amacleod/lampyrida/README.md

Lampyrida Macro Pad
===================

Just a small project for me to practice SK6812 RGB LED soldering.

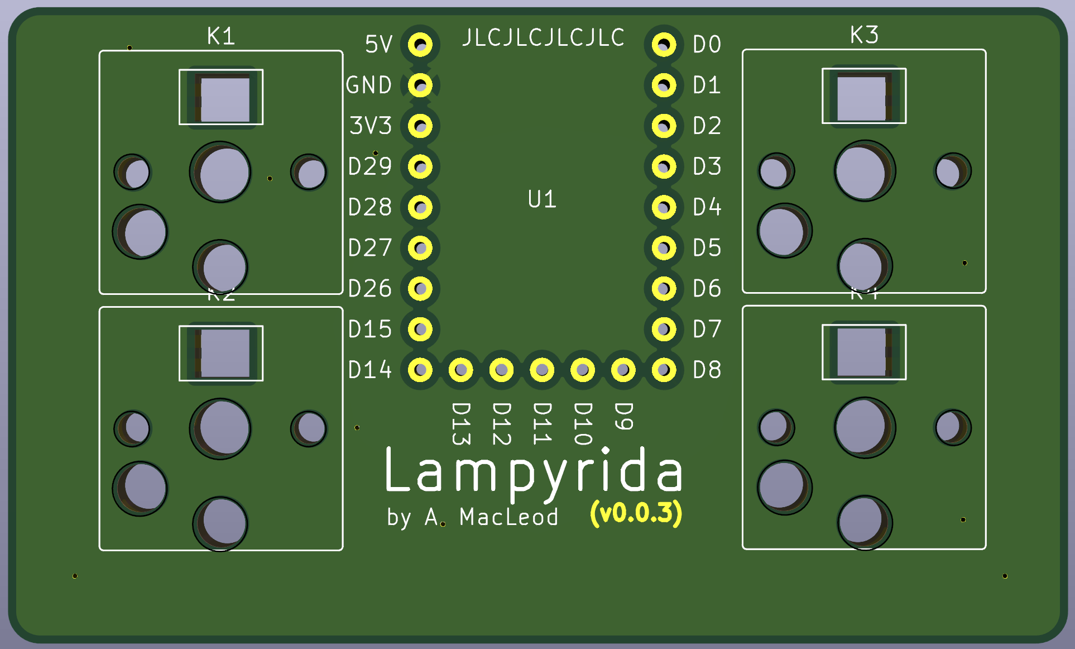
[picture p1: docs/Lampyrida.png]
lampyrida front Lampyrida Front Side
