amacleod/lampyrida/lampyrida.kicad_pcb

## KiCad design lampyrida.kicad_pcb (2025-05-19)

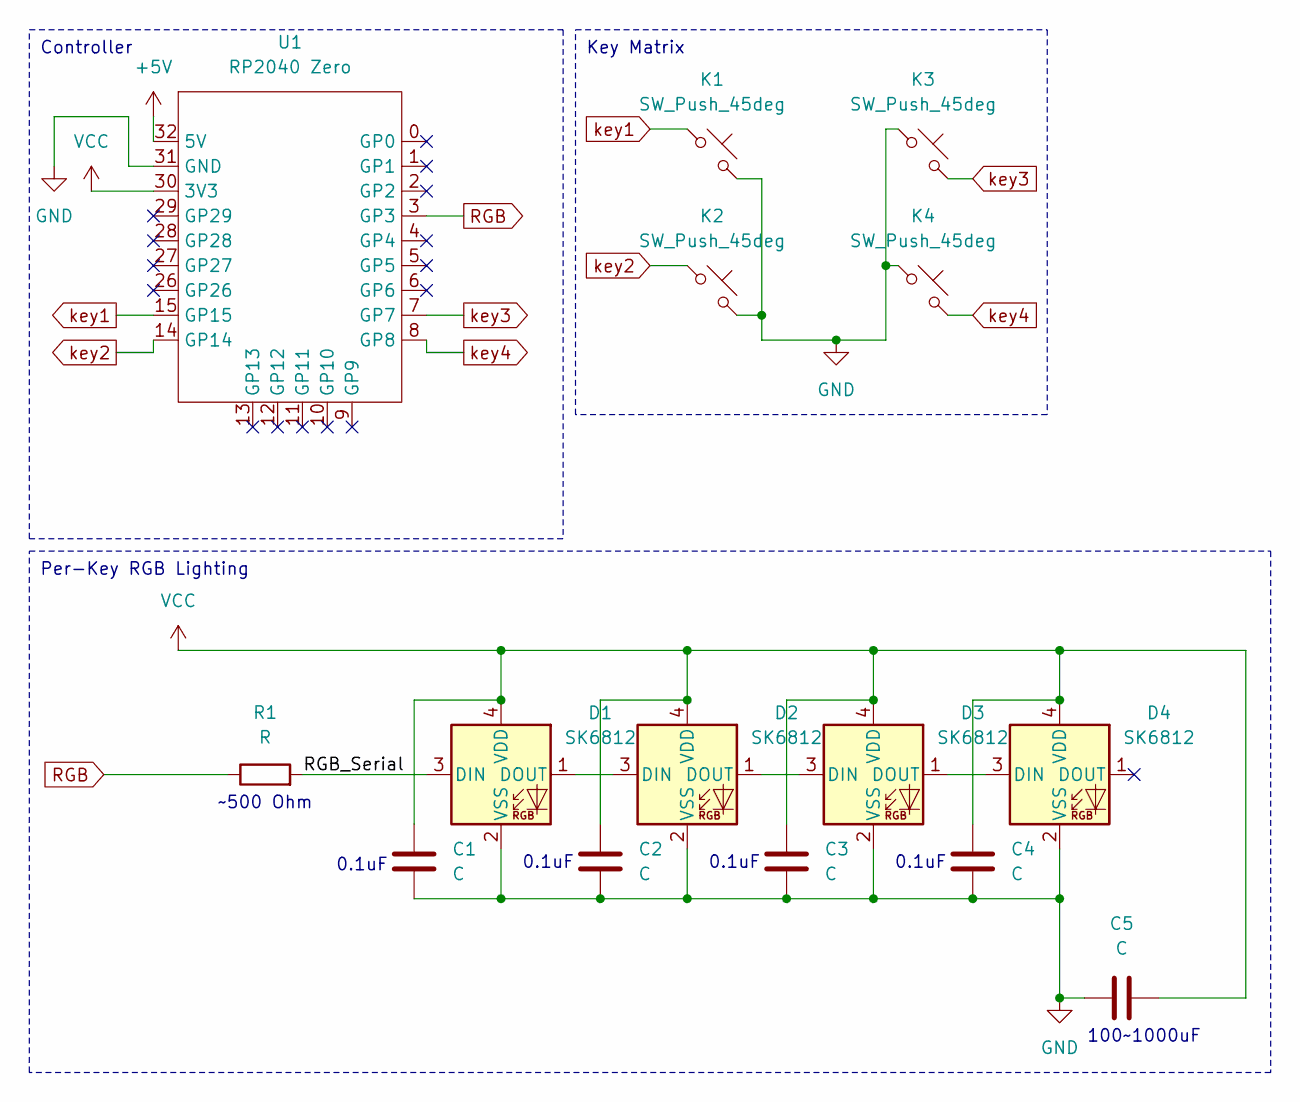
[picture p2: schematic lampyrida.kicad_sch]

Parts:
C1, C2, C3, C4, C5: C; C_1206_3216Metric_Pad1.33x1.80mm_HandSolder
D1, D2, D3, D4: SK6812; LED_RGB_SK6812Mini-E
K1, K2, K3, K4: SW_Push_45deg; Socket_PG1350_Hotswap
R1: R; R_1206_3216Metric_Pad1.30x1.75mm_HandSolder
U1: RP2040 Zero; RP2040 Zero (Through Hole)

Connections:
+5V: U1.32 (5V)
/RGB_Serial: D1.3 (DIN), R1.2
GND: C1.1, C2.1, C3.1, C4.1, C5.2, D1.2 (VSS), D2.2 (VSS), D3.2 (VSS), D4.2 (VSS), K1.2, K2.2, K3.1, K4.1, U1.31 (GND)
unnamed: D1.1 (DOUT), D2.3 (DIN)
unnamed: D2.1 (DOUT), D3.3 (DIN)
unnamed: D3.1 (DOUT), D4.3 (DIN)
RGB: R1.1, U1.3 (GP3)
VCC: C1.2, C2.2, C3.2, C4.2, C5.1, D1.4 (VDD), D2.4 (VDD), D3.4 (VDD), D4.4 (VDD), U1.30 (3V3)
key1: K1.1, U1.15 (GP15)
key2: K2.1, U1.14 (GP14)
key3: K3.2, U1.7 (GP7)
key4: K4.2, U1.8 (GP8)

Notes on the sheet:
Key Matrix
Per-Key RGB Lighting
Controller
0.1uF
100~1000uF
~500 Ohm

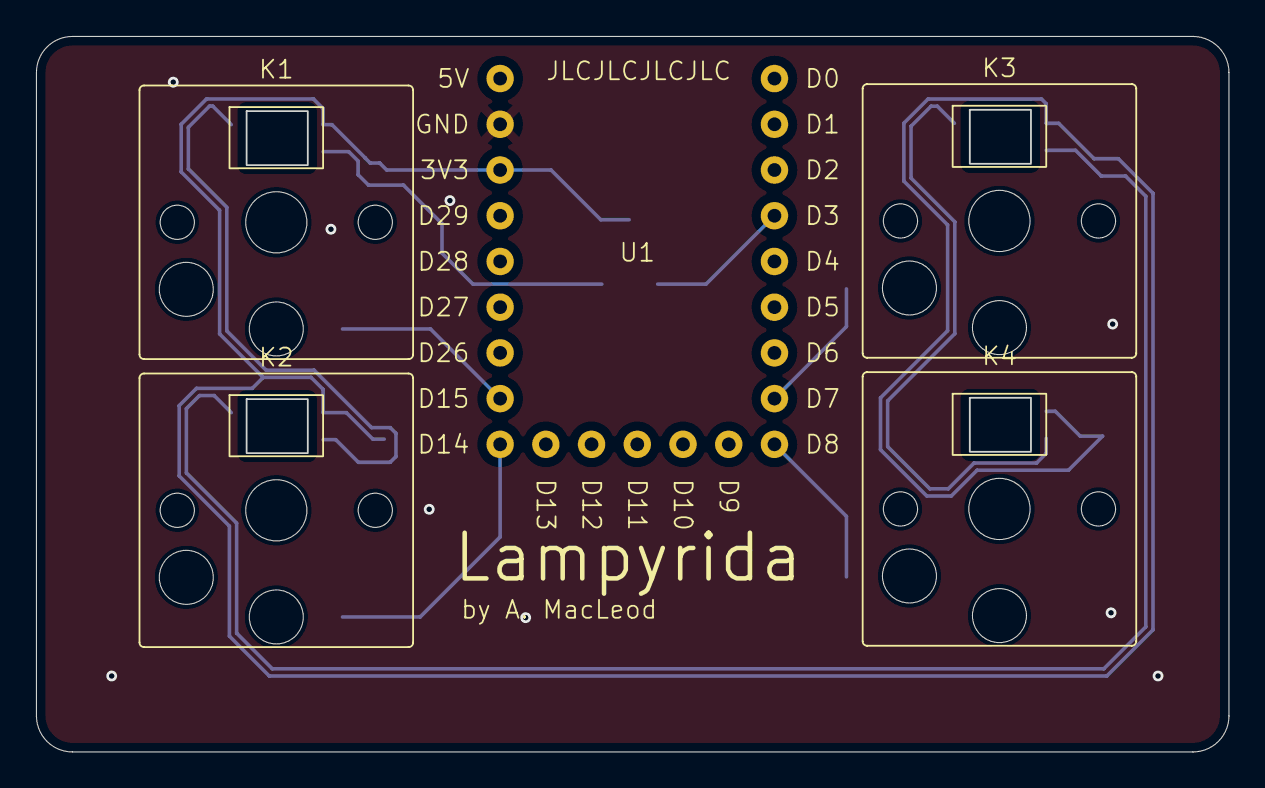
[picture p3: board lampyrida.kicad_pcb from above]

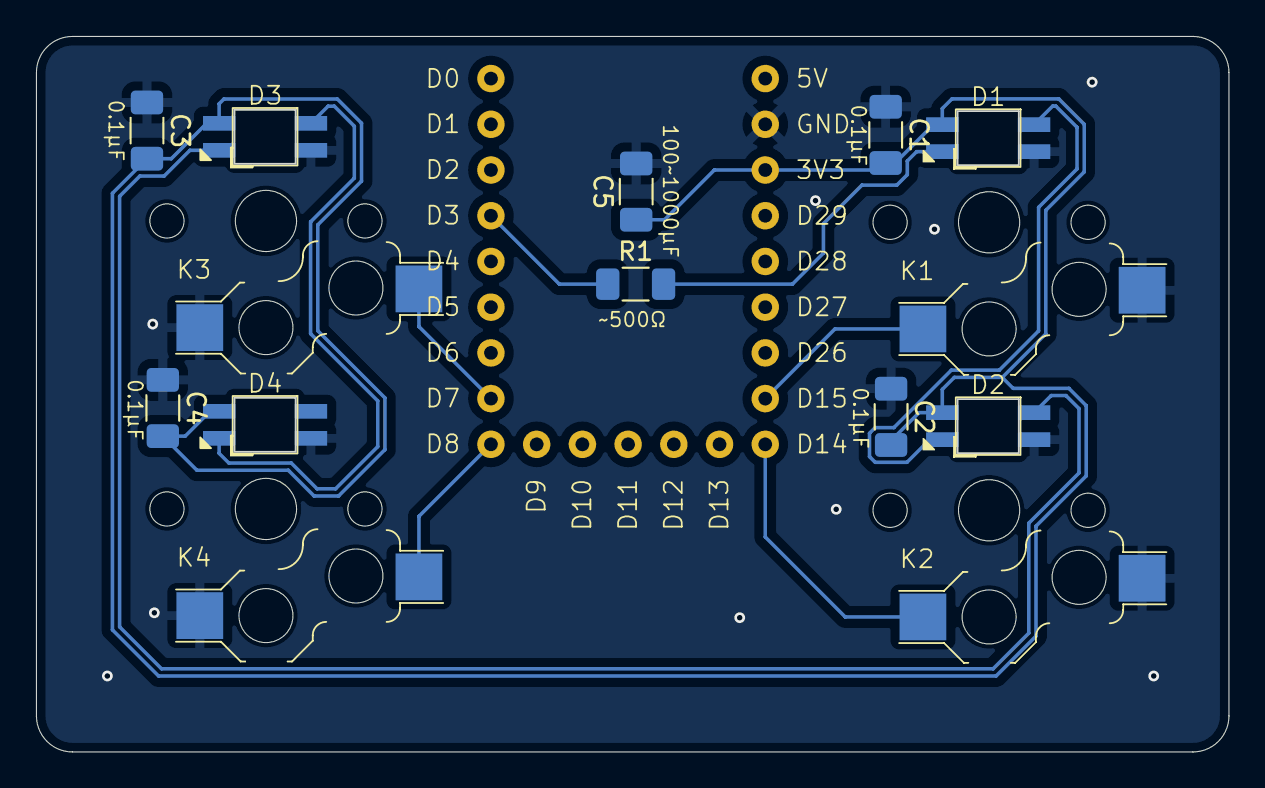
[picture p4: board lampyrida.kicad_pcb from below]

Board: 2 copper layers, 66.2 x 39.8 mm, 15 parts (6 on the bottom side), 11 nets.
