amacleod/lampyrida/(threads)

Thread 1 (2025-03-17):

SK6812 footprint needs adjustment

amacleod, 2025-03-17:
First off, I put them in upside down: the LEDs shine away from the back of the board (towards the bottom of the "keyboard") as opposed to shining upward through the cutouts in the board.

Secondly, the cutouts are not big enough for the shiny half of the LED housing. They are just barely big enough for the opaque half.

Thirdly, the solder pad lands are too far apart for the units I got from Adafruit: they are about the right size and horizontal distance, but they are too far apart vertically by about 0.5 to 1mm. Technically the legs of the unit do touch the pads, but they do not really overlap a lot.

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

Update the footprint so that:
- it is clear which way the LED will shine
- the cutout is big enough for the body of the front of the unit
- solder pad lands are big enough to have significant overlap with the legs

amacleod, 2025-05-18:
Bleh. It turns out I was using one of KiCad's built in footprints, which is apparently for a different size of NeoPixel. I was using `LED_SMD:LED_SK6812_PLCC4_5.0x5.0mm_P3.2mm`which is incorrect.

amacleod, 2025-05-18:
Closed by PR #8

Closed 2025-05-18.

Thread 2 (2025-03-17):

Move capacitors further from LED spots

amacleod, 2025-03-17:
We have plenty of room on the back of the board. Move the surface-mount capacitors to make more room for easy soldering.

Closed 2025-03-23.

Thread 3 (2025-03-17):

Silk screen label placement

amacleod, 2025-03-17:
Minor detail: some of the labels get covered up by components. Notably, half of the LED labels are covered up by hot swap sockets and two of the MCU pin labels are right under C5. It should be easy to move the labels or components around a little so that all the labels are visible even after populating all the components.

amacleod, 2025-05-18:
Mostly fixed by PR #8

Closed 2025-05-18.

Thread 4 (2025-03-17):

Shorten traces on K3 and K4

amacleod, 2025-03-17:
The traces to the keyswitches on the right side of the pad can be shortened and simplified if the ground pin of those switches is on the outer side of them, sort of mirroring the pin choice on K1 and K2.

Closed 2025-03-23.

Thread 5 (2025-03-21):

DIN should have an approximately 500 Ohm resistor

amacleod, 2025-03-21:
Per https://learn.adafruit.com/adafruit-neopixel-uberguide/basic-connections there should be a 470 Ohm resistor between the data output (the level shifter, in Lampyrida's case) and the data-in pin of the first NeoPixel. The datasheet at https://cdn-shop.adafruit.com/product-files/4960/4960_SK6812MINI-E_REV02_EN.pdf says "about 500 Ohm", so 470 should presumably be fine.

The stated purpose of this resistor is to protect the NeoPixels from overcurrent.

Closed 2025-03-23.

Thread 6 (2025-03-21):

Label capacitor values on schematic and PCB.

amacleod, 2025-03-21:
According to https://learn.adafruit.com/adafruit-neopixel-uberguide/basic-connections there should be a 100 to 1000 microfarad capacitor across the power terminals (C5 on the Lampyrida schematic) and a 0.1 microfarad (aka 100 nanofarad) capacitor for each NeoPixel. To aid in recalling those values when populating components, the fab (and possibly even silkscreen) should indicate those values.

Closed 2025-03-23.

Thread 7 (2025-03-21):

Fix ground plane continuity

amacleod, 2025-03-21:
The pads of the RP2040 Zero footprint make a mighty effective barrier against the ground plane on both sides of the PCB. Currently there are vias joining the inner portions of the ground plane, but there is nothing connecting any of the outer portions to the GND pin (except for the small region in the vicinity of C5).

Redo the routing to make sure that everything on the GND net is actually connected.

amacleod, 2025-03-21:
It may be worth deleting the pads for the bottom row of pins; I am not even using a header there.

Closed 2025-03-23.
