amacleod/lampyrida/(commit log)

2025-02-08 Lampyrida macropad v0.0.1
    [lampyrida.kicad_pcb, lampyrida.kicad_sch]
2025-02-26 Added Kee Boar KB2040 to the symbol library.
    [lampyrida.kicad_pcb]
2025-03-23 Add R1, improve ground plane, add labels.
    Fixes #7 by making more room for the ground pour to go around things
    and with some better-placed vias.
    Fixes #6 by adding labels, both in schematic and PCB, for capacitors
    and the new resistor.
    Fixes #5 by adding a spot for a 500-ish Ohm resistor on the LED data
    input line.
    Fixes #2 by moving C1 further away from the LED footprint.
    [lampyrida.kicad_pcb, lampyrida.kicad_sch]
2025-03-23 Fixes #4 by swapping which end of K3 and K4 is connected to ground.
    [lampyrida.kicad_pcb, lampyrida.kicad_sch]
2025-05-13 Removing level shifter to use 3.3V power and signal with SK2812 LEDs.
    [lampyrida.kicad_sch]
2025-05-13 Rerouting traces with new non-5V net.
    [lampyrida.kicad_pcb, lampyrida.kicad_sch]
2025-05-18 Fixing SK6812-MiniE footprint and rerouting traces to match. (#8)
    [lampyrida.kicad_pcb, lampyrida.kicad_sch]
2025-05-19 Correcting DRC violations.
    [lampyrida.kicad_pcb, lampyrida.kicad_sch]
